sunrise-labs/farmers-iot-toolkit/hardware/hardware.md

# MPPT Solar Charger
Option A)
90W CN3722 Solar MPPT Charger Module 1S 2S 3S 4S Li-ion/LiFePO4 Lead-Acid Battery 7.2V 8.4V 12V 12.6V 16.8V 2A Charging Current
https://www.aliexpress.com/item/1005009883114947.html

Option B)
12V Charging Management 18V Solar 3-series Lithium Battery Charger MPPT Solar Controller CN3722
https://www.aliexpress.com/item/1005004653397155.html

# Solar panel
Voltify Mono PERC Solar Panel 20W 375x350x17mm
https://www.marine-deals.com.au/rv-solar-panels-chargers/voltify-mono-perc-solar-panel-20w-375x350x17mm/p/177917/c/1686
AUD $31.99 (SKU 177917) — also sold on the marine-deals NZ site

Mono-crystalline PERC, 32 cells, 15.44% module efficiency
Max power 20W (+3% tolerance) · Vmp 18.6V · Imp 1.08A · Voc 22.8V · Isc 1.15A
375 x 350 x 17mm, 2.5kg · anodised aluminium frame with mounting slot
3.2mm ultra-white tempered glass · bypass diodes · waterproof (marine-rated) junction box
25-year linear power warranty · IEC 61215 / IEC 61730 / TUV / CE
Vmp 18.6V suits the CN3722 MPPT above (spec'd for an 18V panel into a 3S pack)

# Water level sensor
### went with RS485 variant
Option A)
0-10M Hydrostatic Submersible Level Transmitter 4-20mA RS485 0-5V 0-10V Output for Water Tank Fire Pool IP68 Water Level Sensor
https://www.aliexpress.com/item/1005009844410509.html

Option B)
HTP-300Y Submersible Pressure Transmitter IP68 4-20mA RS485 0-10V 316L Stainless Steel Hydrostatic Level Sensor
https://www.aliexpress.com/item/1005009911856204.html

Option C)
Factory Sale Hydrostatic Submersible Water Level Sensor 4-20ma 0-10V RS485 Output Liquid Level Transmitter QDY30A
https://www.aliexpress.com/item/1005006415176688.html

# Soil sensor
### went with RS485 variant
Measure Soil Moisture Temperature Humidity EC PH NPK 4-20mA 0-5V RS485 Modbus Soil Sensor
Model: THC-S
https://www.aliexpress.com/item/1005001524845572.html

# RS485 components
RS485 RS232 MAX485 TTL CAN to Serial Port Conversion Module Level Convertor Board 232 Turn UART 3.3V 5V MAX485CSA RS-485
https://www.aliexpress.com/item/1005003716689999.html

FT232 USB 2.0 to TTL RS485 485 Serial Converter Adapter FTDI Module FT232RL SN75176 double function double for protection
https://www.aliexpress.com/item/1005006448907596.html

# Diode
1N5819
https://www.aliexpress.com/item/1005001552094086.html

# Mini360 DC-DC Buck
Mini360 DC-DC Buck Converter Step Down Module MP2307 4.75V-23V to 1V-17V 340KHz 17x11x3.8mm For Flight Control Car Module
https://www.aliexpress.com/item/2038556861.html

# Logic Level Control
4 Channels IIC I2C Logic Level Converter Bi-Directional Module 3.3V to 5V Shifter for Arduino
https://www.aliexpress.com/item/1005005984772131.html

# ESP8266
ESP8266 serial port wifi module NodeMCU Lua V3 Internet of Things development board TYPE-C interface CH340
https://www.aliexpress.com/item/1005006889833004.html

# LoRa
### 868mhz variant
Heltec WiFi LoRa 32(V3) Dev-board USB Type C with SX1262 ESP32-S3 LORA node with Wi-Fi BLE LoRa OLED display
https://www.aliexpress.com/item/1005006902338879.html

# MT3608 Boost
MT3608 Boost Module DC-DC Step Up Converter Booster Power Supply Module Board 2A Max 2V-24V To 5/9/12/28V for Arduino
https://www.aliexpress.com/item/1005006361814667.html

# Solenoid Valves
Dc 12V 220V Plastic Electric Solenoid Valve Normally Closed Pressure Solenoid Valve Inlet Valve Inlet Flow Switch
https://www.aliexpress.com/item/1005006146766362.html
