sunrise-labs/farmers-iot-toolkit/docs/bench/max485-hw0519.jpg

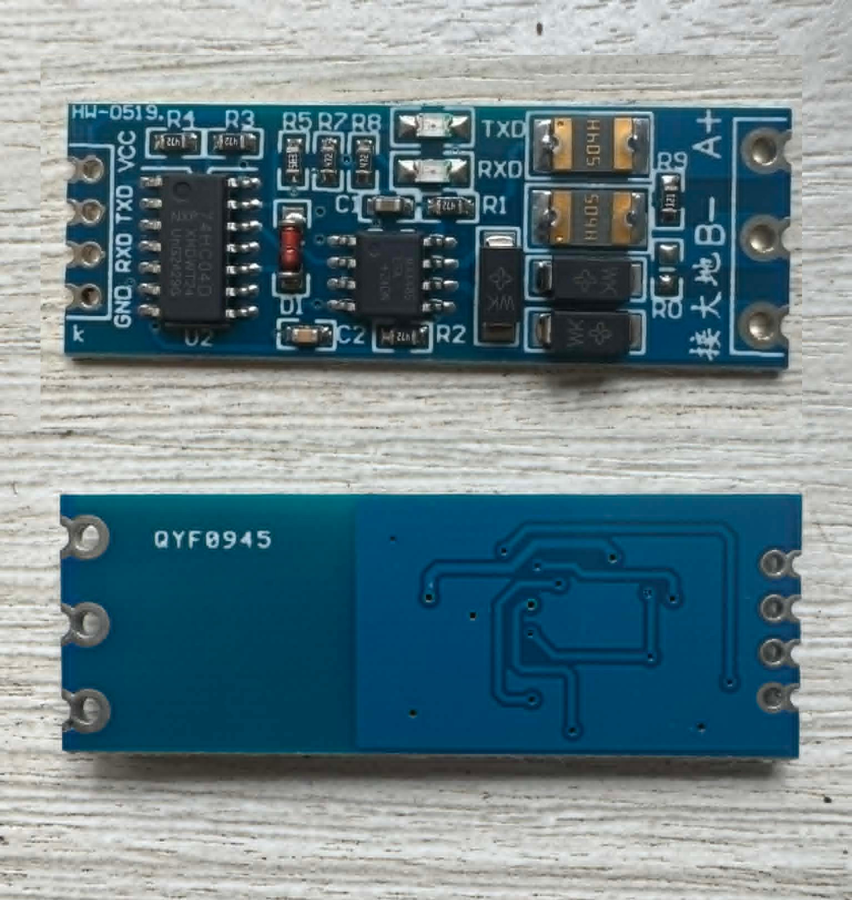
docs/bench/max485-hw0519.jpg
