sunrise-labs/farmers-iot-toolkit/docs/bench/soil-sensor-wires.jpeg

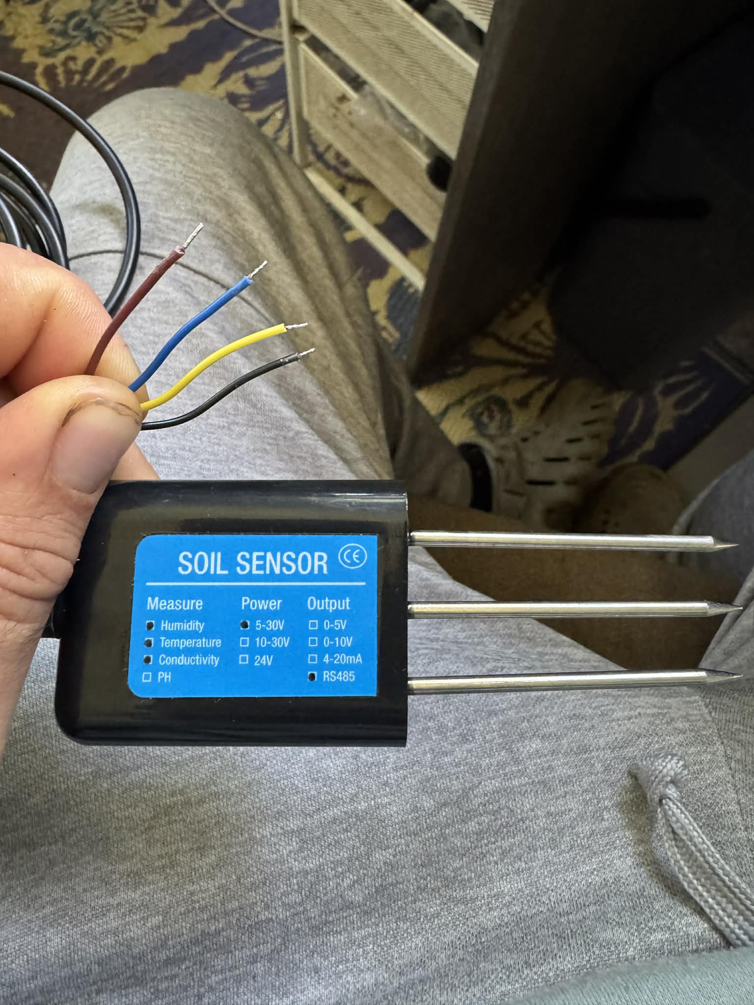
docs/bench/soil-sensor-wires.jpeg
