sunrise-labs/farmers-iot-toolkit/docs/bench/usb-rs485-bottom.jpeg

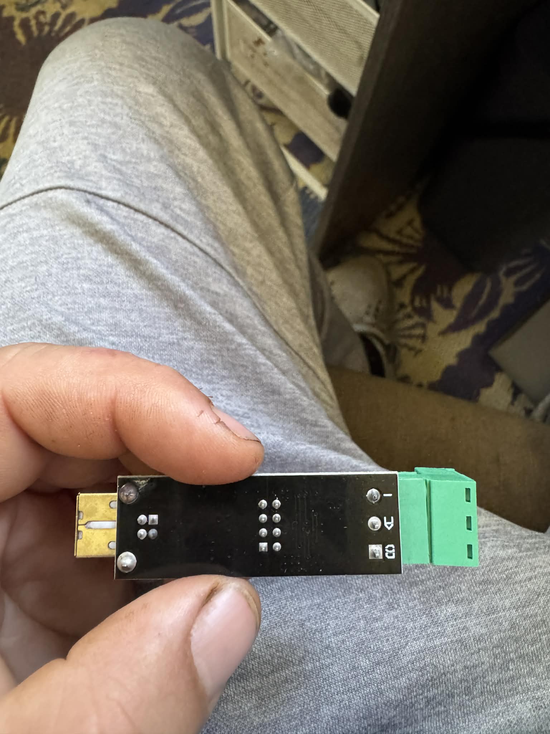
docs/bench/usb-rs485-bottom.jpeg
