sunrise-labs/farmers-iot-toolkit/docs/bench/usb-rs485-top.jpeg

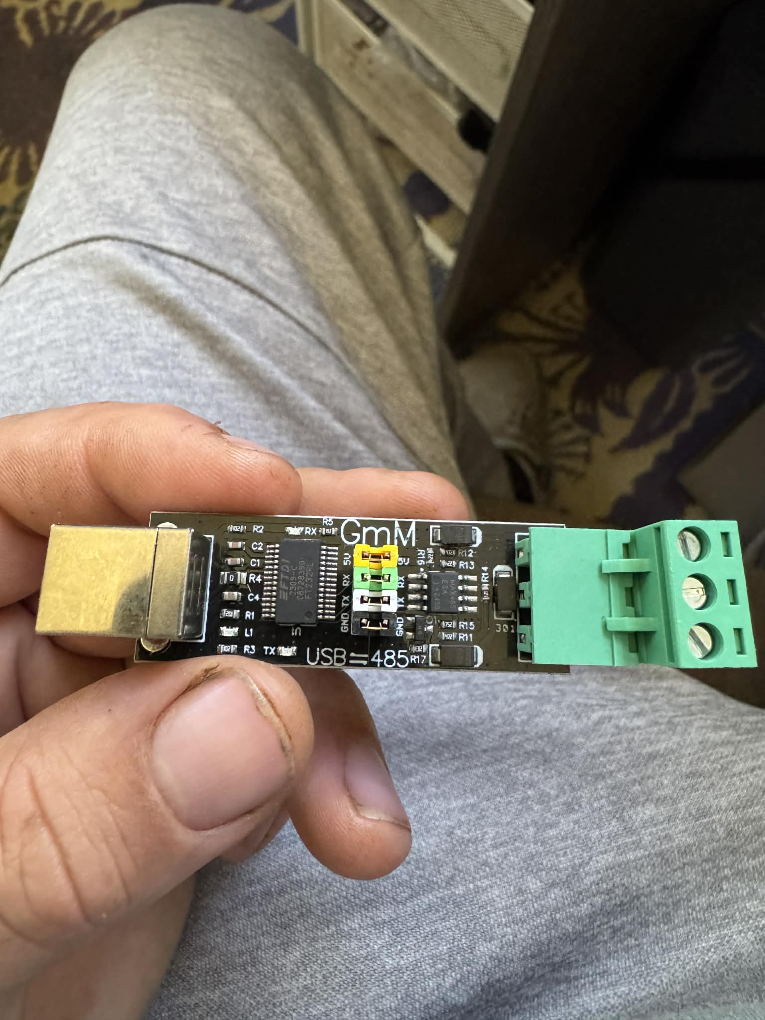
docs/bench/usb-rs485-top.jpeg
