sunrise-labs/farmers-iot-toolkit/hardware/android-charging-2.webp

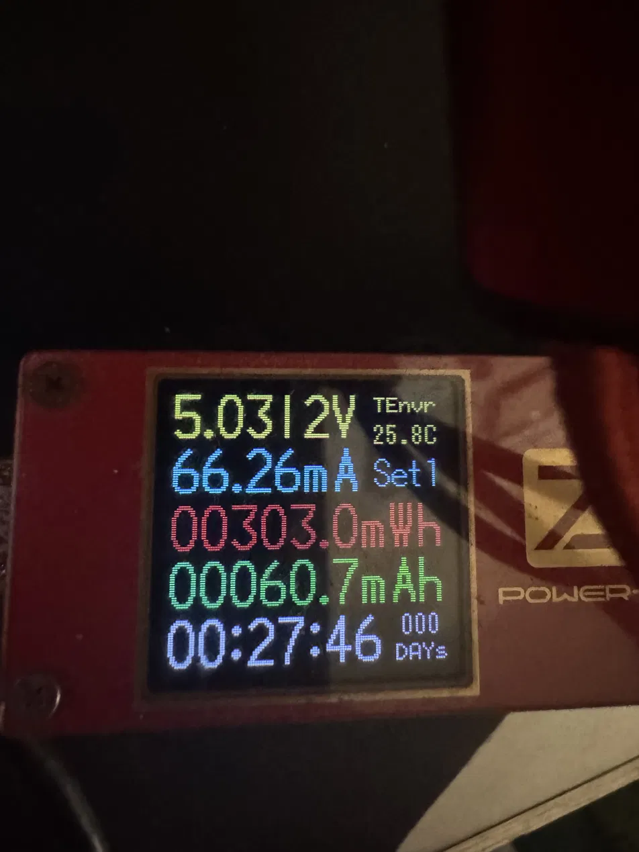
hardware/android-charging-2.webp
