sunrise-labs/farmers-iot-toolkit/hardware/android-charging.webp

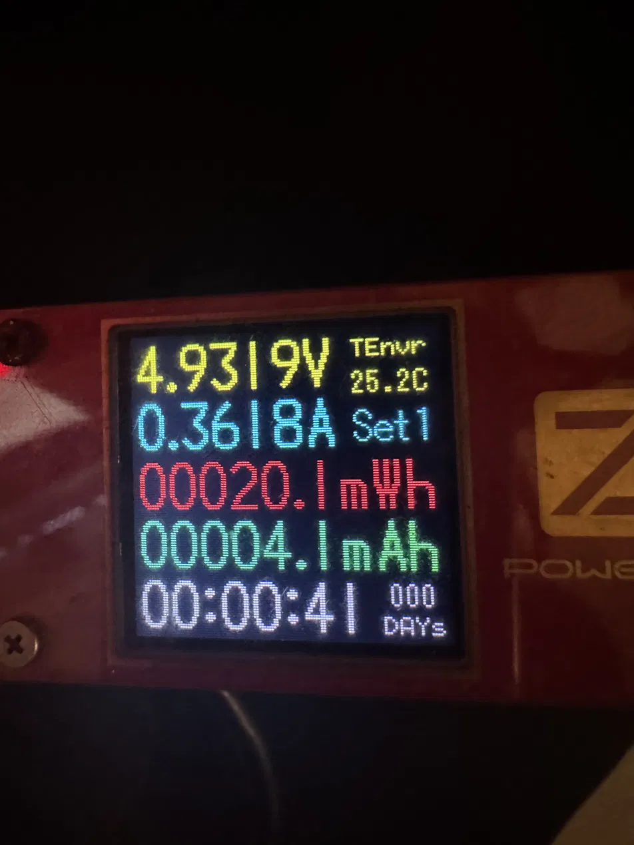
hardware/android-charging.webp
