sunrise-labs/farmers-iot-toolkit/docs/fritzing parts/solenoid-2.jpeg

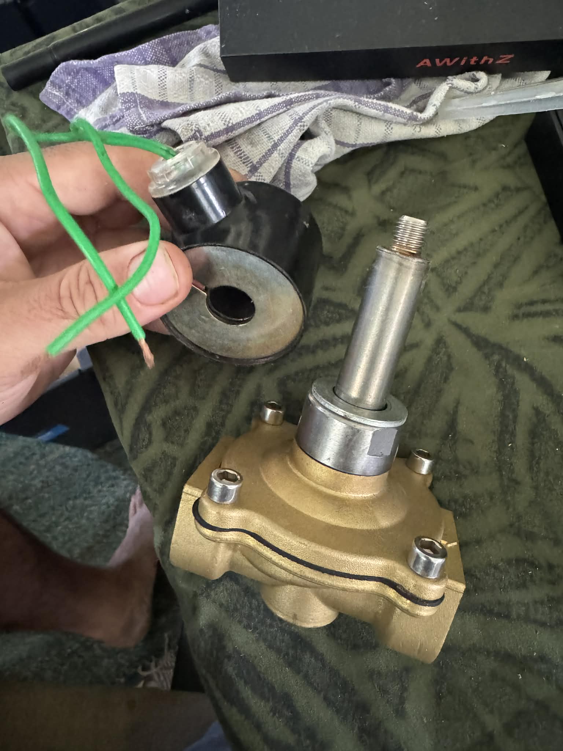
docs/fritzing parts/solenoid-2.jpeg
