sunrise-labs/farmers-iot-toolkit/hardware/Manual - MT3608 Boost.pdf

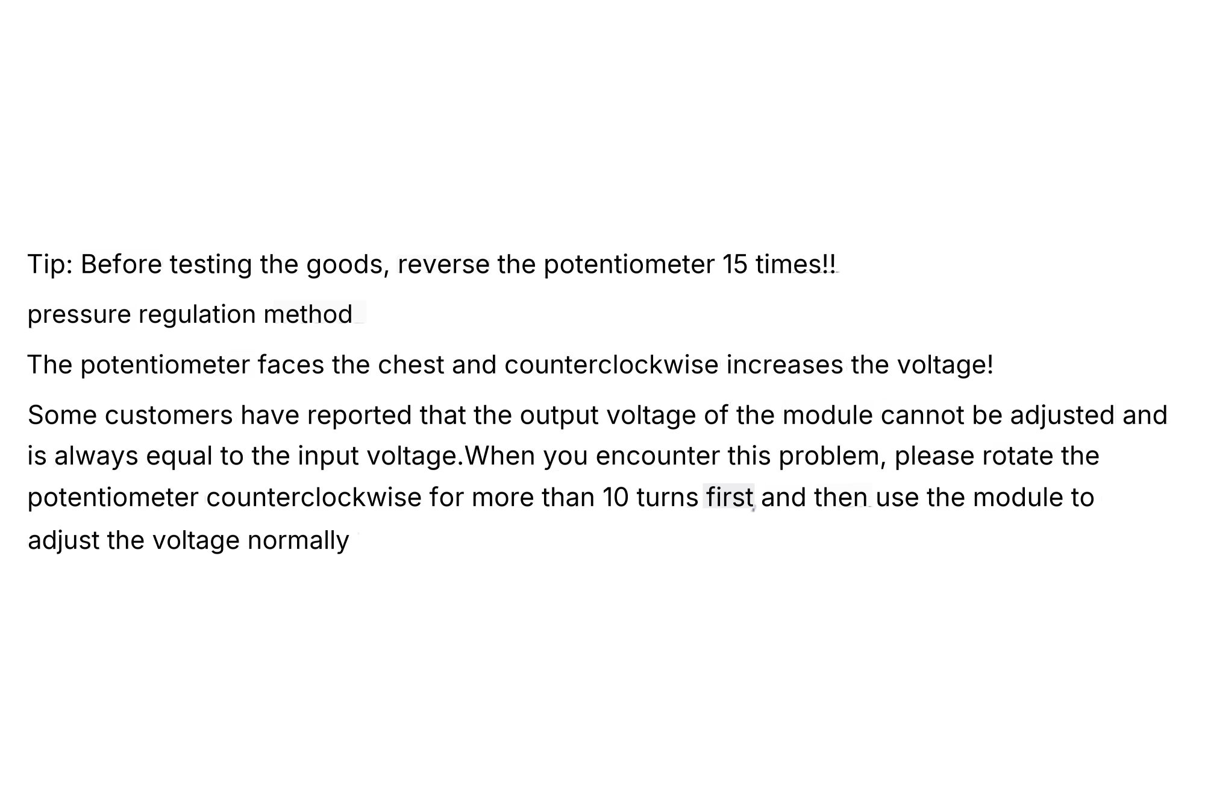
[picture p9: page 1]
