sunrise-labs/farmers-iot-toolkit/docs/wiring-cheatsheet-full.jpg

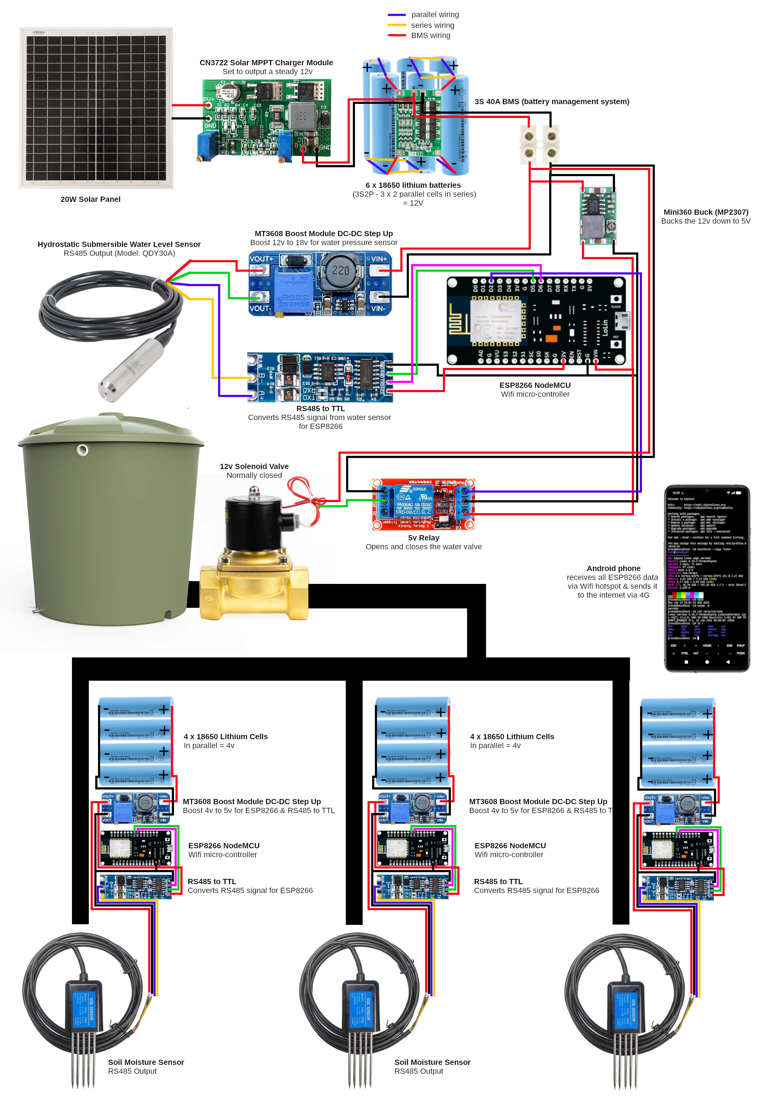
docs/wiring-cheatsheet-full.jpg
