sunrise-labs/farmers-iot-toolkit/docs/wiring-diagram-module-1-power.jpg

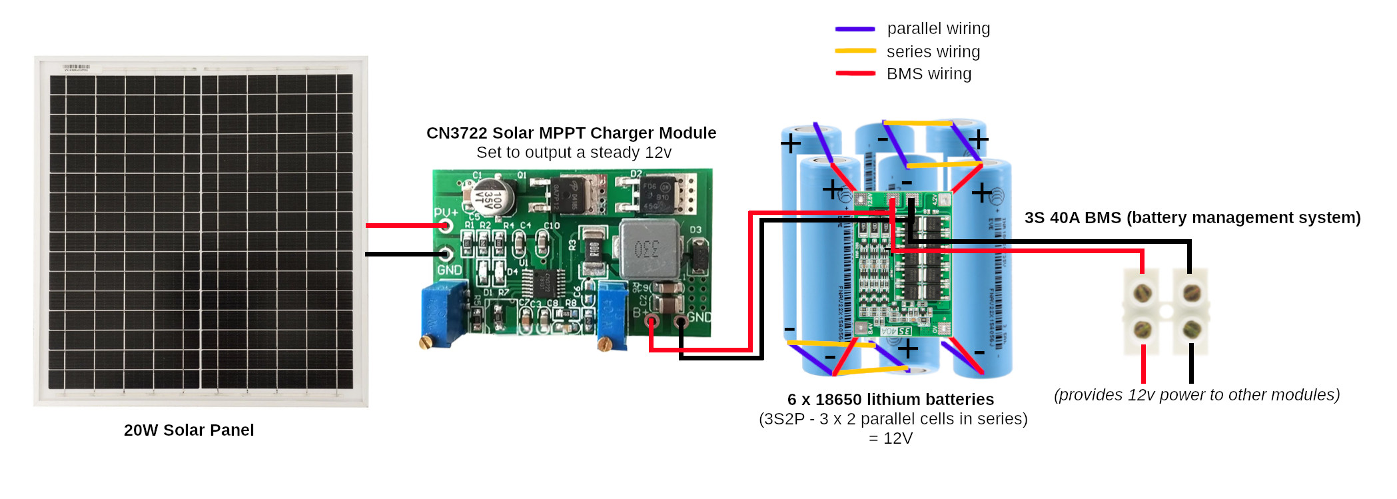
docs/wiring-diagram-module-1-power.jpg
