sunrise-labs/farmers-iot-toolkit/docs/wiring-diagram-module-2-water.jpg

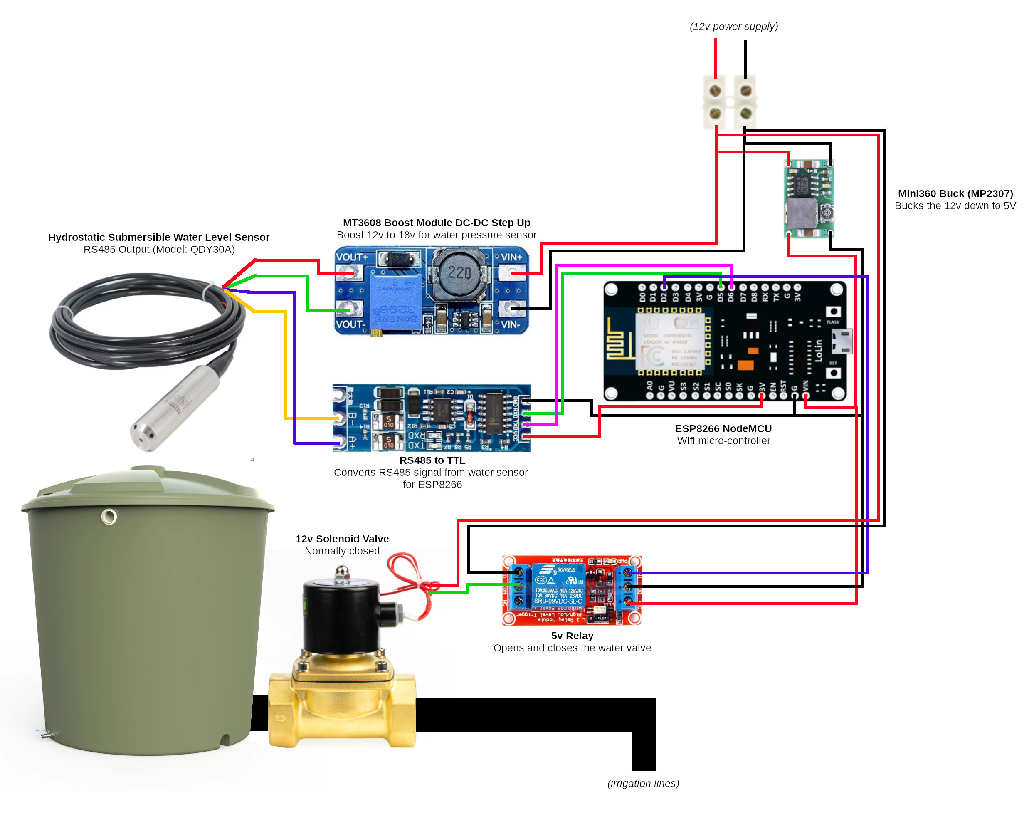
docs/wiring-diagram-module-2-water.jpg
