sunrise-labs/farmers-iot-toolkit/docs/wiring-diagram-module-3-soil.jpg

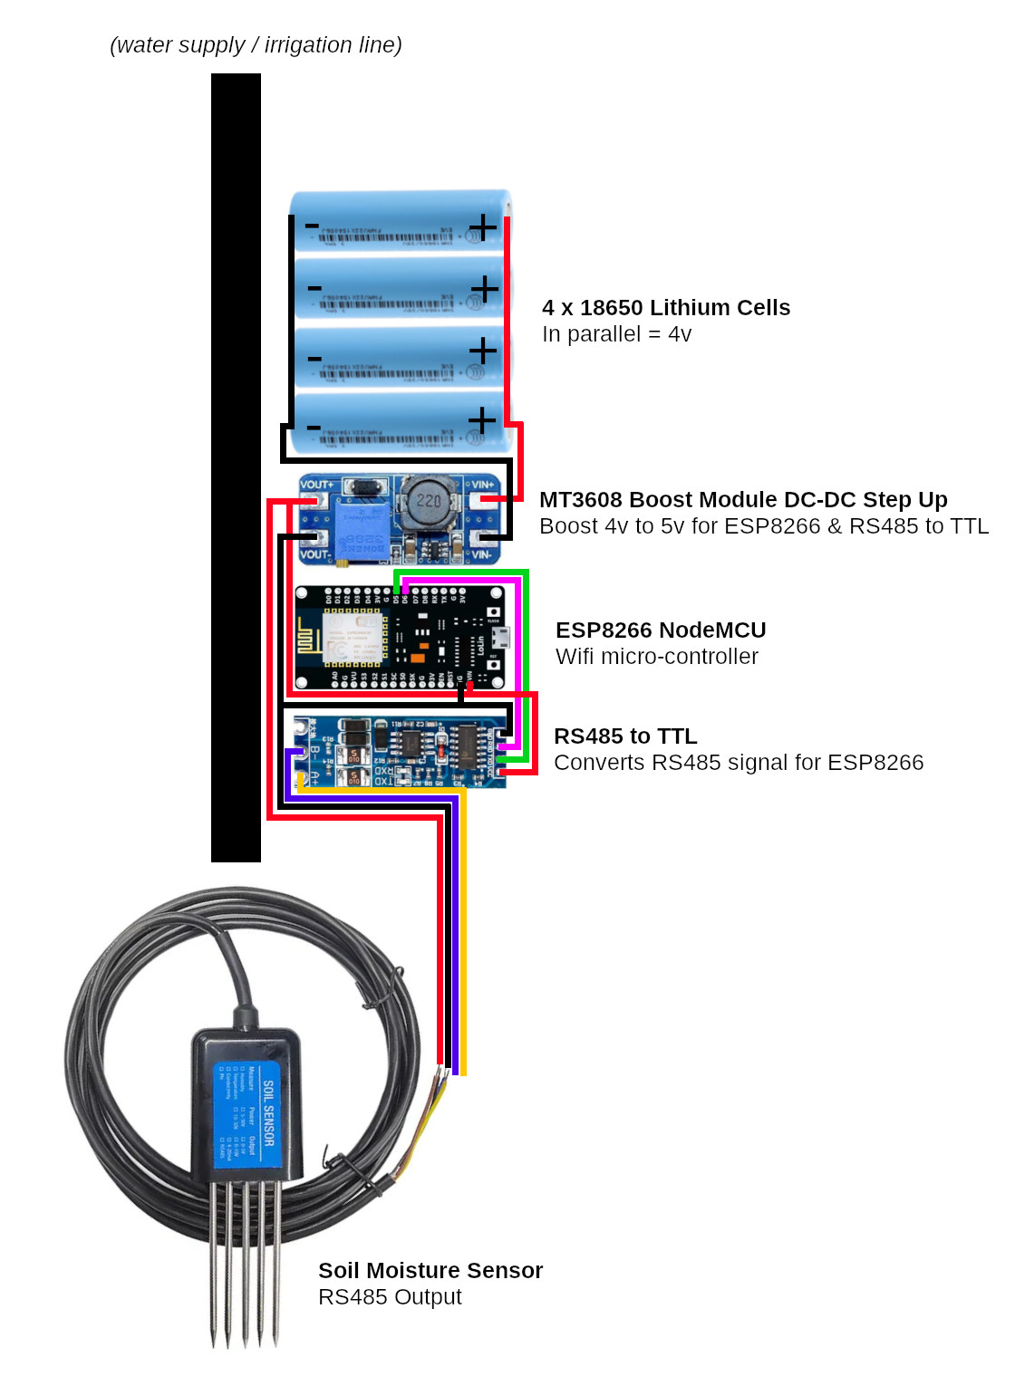
docs/wiring-diagram-module-3-soil.jpg
