sunrise-labs/farmers-iot-toolkit/docs/wiring-diagram-module-4-phone.jpg

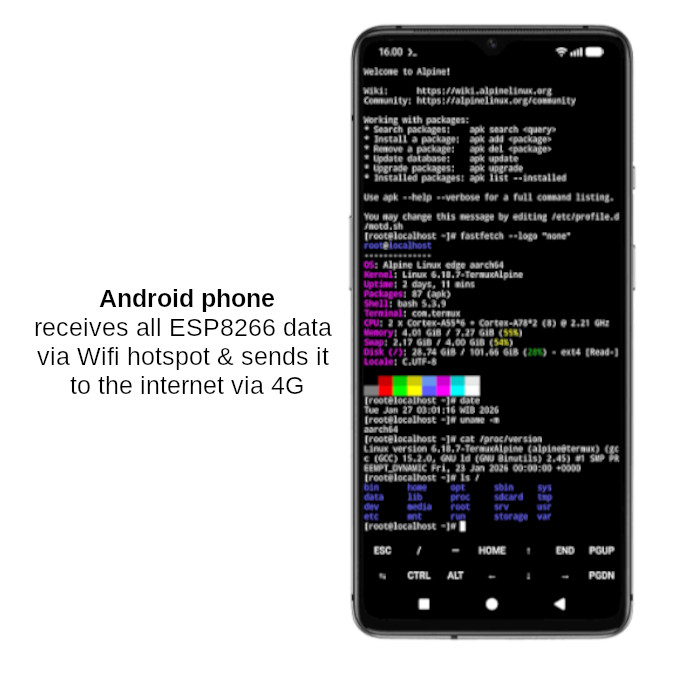
docs/wiring-diagram-module-4-phone.jpg
