sunrise-labs/farmers-iot-toolkit/hardware/Manual - USB to TTL.webp

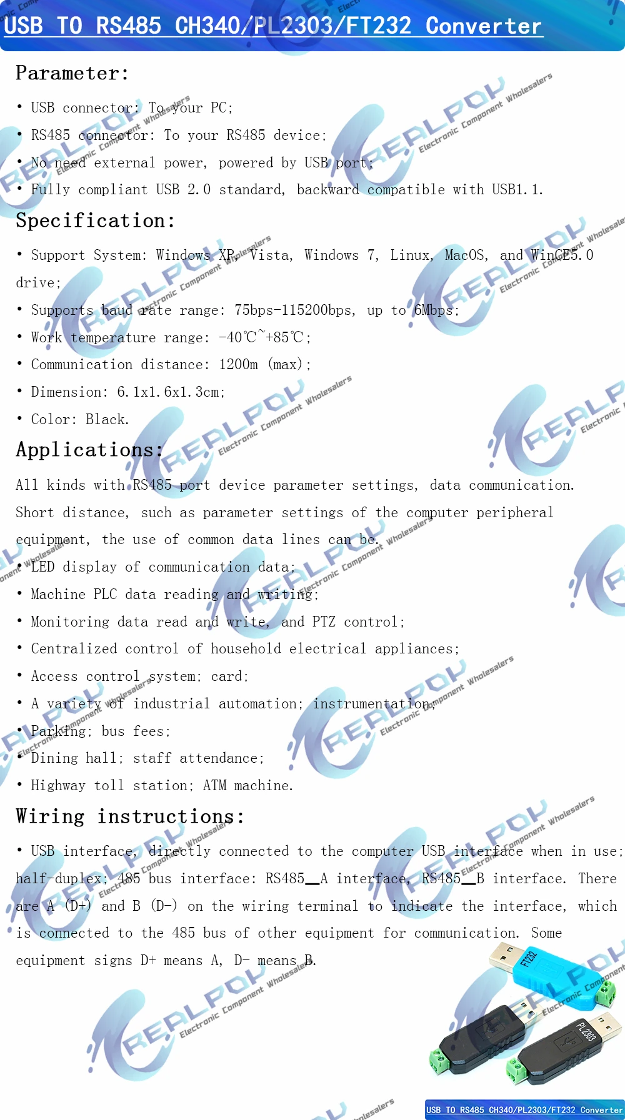
hardware/Manual - USB to TTL.webp
