sunrise-labs/farmers-iot-toolkit/(commit log)

2026-02-24 Initial commit: README, module docs, and Float funding proposal
    Add project README with background on Float discovery proposal,
    4-module overview table, and links to individual module docs.
    Add documentation templates for all 4 modules:
    - Water Tank Level Sensor (beginner)
    - Soil Moisture Sensor to Drip Irrigation (advanced)
    - IoT Solar Powerbank (medium)
    - Mobile WiFi Base Station (beginner)
    Each doc uses YAML front matter for structured metadata and
    plain-language markdown for accessibility.
    Include original Float funding proposal (markdown + PDF).
2026-07-14 Add hardware manuals, soil sensor config tool, and hardware notes
2026-07-14 Add RS485 bench test guides for soil and water level sensors
    Shared bench rig, plus per-sensor walkthroughs for reading Modbus RTU
    into the ESP8266 via MAX485.
    Power: no bench 12V available. Soil THC-S (4.5-30V) runs direct off the
    3S2P pack. Water QDY30A needs 12-36V, so the pack is boosted to 24V with
    the MT3608 rather than run under-spec.
    Water level register map is absent from all three manuals; guide includes
    an empirical discovery procedure instead of a guessed table.
2026-07-14 Add QDY30A Modbus register map from community sources
    Manual has no Modbus section. Map reconstructed from three independent
    HA/ESPHome integrations that agree: addr 1, 9600 8N1, FC 0x03.
    Level in 0x0004 (int16 signed); 0x0002 unit code and 0x0003 decimal
    places set its scaling. Config writes need a follow-up write of 0 to
    0x000F or they are lost on power cycle.
    Verified the community read frame 01 03 00 04 00 01 C5 CB is valid
    Modbus RTU by recomputing its CRC. Semantics still confirmed on-bench
    via block read + ruler calibration.
2026-07-14 Handle unknown water sensor model: 3 options are really 2 sensors
    Options A and C are byte-identical PDFs (same MD5) - both QDY30A. Option B
    is a different sensor entirely (HTP-300Y), whose manual has no wire colours,
    no baud rate and no register map; it defers to 'the wiring definition
    provided by the seller'.
    Drop the boost target from 24V to 18V. Supply ranges are QDY30A 12-36V and
    HTP-300Y 9-24V, overlapping at 12-24V. 18V is safe for either, so the rig
    can be powered before the model is identified. 24V is the HTP-300Y's
    absolute maximum and a bad default while the model is unknown.
    Add an identification section; the step 2 block-read doubles as the
    identification test.
2026-07-14 Record that no HTP-300Y register map exists publicly
    Searched for it; there is no datasheet, community integration, or forum
    thread. Note the false-positive trap: 'HTP Modbus' searches surface Heat
    Transfer Products (a boiler maker) whose Modbus adapter docs look relevant
    but configure via an installer menu on a boiler.
    Advise trying the QDY30A map on it regardless (these transmitters share a
    firmware family), and warn that reads are safe but blind writes can hit the
    address/baud registers and lock you out of the sensor.
2026-07-14 Expand Step 0 into a full walkthrough
    Step 0 was a paragraph pretending to be a procedure. Now covers: what the
    FT232 adapter is and which terminals to use, finding /dev/ttyUSB0 (with
    dmesg fallback), wiring diagram with per-sensor colour table, every mbpoll
    flag explained, the 1-based vs 0-based register off-by-one, what success
    and timeout look like, an ordered fault list, and proving the reading is
    real by making it move.
    Two corrections from checking the actual machine: mbpoll is NOT in the Arch
    official repos (it's AUR - yay -S mbpoll-git), and Ian is already in the
    uucp group so the usermod step was unnecessary.
2026-07-16 feat(bench): prove soil + water RS485 sensors end-to-end
    - add tools/poll-soil.ts (4800) and tools/poll-water.ts (9600),
    adapter-tolerant pollers that work around the FT232+SN75176 CRC/turnaround issue
    - confirm register maps and liveness for both sensors on the bench
    - devlog: bring-ups + gotchas (mbpoll, MT3608 25-turn pot, two-fd at 9600)
2026-07-16 docs(bench): add wiring photos + 3S2P pack handoff doc
2026-07-16 feat(bench): close water sensor ruler test — 1 count = 1 mm confirmed
    Step 4 of the water-level bench guide is done. Four points over a 90 mm span
    fit level_cm = 0.10363 * raw - 1.824 (R2 = 0.9966): within 3.6% of the 0.1
    the register map implies, and 865% from the "raw is cm" alternative.
    The community register map was RIGHT. unit=0x11 (cm) with decimals=1 means
    counts of 0.1 cm, which IS 1 mm/count. The documented mm-vs-cm trap only
    catches people who read decimals=1 and then treat raw as cm anyway.
    Three findings worth more than the verdict itself:
    - You cannot calibrate a 5 m sensor in a bucket. The manual specs 0.5% F.S
    accuracy (±25 mm) and ±2% F.S zero drift (±100 mm), so a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
2026-07-16 docs(module-1): rewrite water tank sensor for the pressure probe we built
    docs/01 described an HC-SR04 ultrasonic sensor on an ESP32 — a design that was
    never built. It's now the QDY30A submersible pressure probe on an ESP8266 +
    MAX485, matching hardware.md, the bench guide, and the rig that just passed its
    ruler test.
    Rewritten rather than patched: the sensor, board, wiring, power chain, scaling,
    accuracy and troubleshooting were all wrong, and a stale beginner guide is worse
    than none — this is the doc a farmer follows.
    Carries over what the bench work actually taught: set the boost to 18V before
    the probe exists, one common ground or you get random failures, 9600 baud here
    vs 4800 f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
2026-07-16 feat(firmware): ESP8266 water level node — reads probe, POSTs JSON to Node-RED
    First of our own firmware. Compiles clean for nodemcuv2 (flash 24%, RAM 36%).
    Not yet flashed or run against real hardware.
    Resolves the "Frugal IoT vs custom" decision that was blocking all sensor
    coding: build it ourselves first, get the system fully working, then evaluate
    what a framework would gain or lose us. You can't judge an abstraction until
    you've felt the problem it claims to solve. Mitra Ardron's collaboration offer
    stands — this is sequencing, not rejection.
    Decides the ESP -> base station protocol, which module 4 never specified:
    HTTP POST of JSON, not MQTT. MQTT means running a broker on an An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
    [config.example.h, water-level.ino]
2026-07-16 feat(firmware): add BENCH_MODE for serial-only bring-up
    First bring-up shouldn't be debugging the RS485 chain and WiFi at once. With
    BENCH_MODE 1 the radio is off, there's no POST, and it polls every 2s straight
    to serial — so a wiring mistake shows up in two seconds instead of being tangled
    up with "is the base station even running".
    Defaults to 1 in config.example.h. A first-time builder gets a working serial
    test immediately, then flips it to 0 once the probe reads reliably.
    Also kills the 20s-per-cycle WiFi wait during bench work, and turns the radio
    off entirely — less power, and less RF noise sitting next to the RS485 pair.
    Both paths compile for nodemcuv2: bench 23% flash, WiFi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
    [config.example.h, water-level.ino]
2026-07-17 fix(firmware): cut modbus read timeout 1000ms -> 300ms
    A dead probe took ~16s to report (15 retries x a 1s deadline), which makes every
    wiring mistake agonising to diagnose and burns solar-node CPU retrying nothing.
    300ms is ~5x the worst real turnaround: a 7-byte reply at 9600 is ~7ms on the
    wire and the probe answers well inside 50ms. The bench poller has been using a
    400ms window reliably since day one. Failure now reports in ~5s.
    Verified on hardware: flashed to the NodeMCU, bench mode boots with no WiFi and
    correctly reports {"ok":false,"error":"no valid modbus frame"} with no probe
    attached — error path confirmed before the sensor is even wired.
    Also worth recording: `arduino-cli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
    [water-level.ino]
2026-07-17 feat(module-1): ESP8266 reads the probe — full chain works on its own hardware
    raw=153 depth=127 mm
    {"node":"water-tank-1","ok":true,"raw":153,"depth_mm":127,"uptime_s":2}
    ESP8266 -> HW-0519 -> RS485 -> QDY30A -> back, CRC-valid, ruler-test scaling and
    dry offset applied. No laptop in the chain. Module 1 stands on its own hardware.
    Two hardware traps found and documented, both of which cost real time:
    1. The MAX485 listing in hardware.md ships TWO different boards. We got an
    HW-0519 auto-direction module with NO DE/RE pins — a 74HC04D derives the
    transmit-enable from TXD itself. Every guide (ours included) assumed the
    classic breakout. Wiring is RXD->D5, TXD->D6, VCC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
2026-07-17 fix(firmware): resync on frame header — kills the auto-direction echo timeouts
    Before: clean reads interleaved with runs of `timeout`, most of the 15-retry
    budget spent to land 5 good samples.
    After: 5 good reads, 0 timeouts, 0 failures in the same 20s window on hardware.
    Cause: the HW-0519 (like the FT232 adapter before it) echoes our own transmitted
    bytes back into the receive path, so the buffer is
    01 03 00 04 00 01 C5 CB | 01 03 02 00 99 ...
    └──── our echoed request ──┘ └── the real reply ──┘
    Parsing from byte 0 landed on the echo, failed CRC, and scored a timeout — the
    same fault that made mbpoll report "Invalid CRC" on every frame back in Jul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
    [water-level.ino]
2026-07-17 docs(module-4): write the Termux + Node-RED steps that were never written
    docs/04 said "(instructions to be added)" for Termux, Node-RED, and the flow —
    module 4 is marked Done in STATUS.md, but the knowledge only existed in Ian's
    head. Six months from now that's indistinguishable from not having built it, and
    it's a deliverable.
    Now documents the three things that actually cost time, none of which are obvious
    and all of which fail in misleading ways:
    - Termux MUST come from F-Droid. The Play Store build is abandoned and frozen;
    pkg installs fail on it looking like network errors, so you blame your wifi.
    - `npm install -g --unsafe-perm node-red` — without the flag it dies partway
    t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
    [water-level.ino]
2026-07-17 feat(firmware): derive the base station address from the gateway, not config
    END TO END WORKING: probe -> ESP8266 -> WiFi -> Node-RED on the phone.
    `POST: 200 ok` with NO IP configured anywhere.
    The Android hotspot is not on 192.168.43.1. Every guide says it is; ours came up
    on 10.215.63.55. Modern Android randomises the hotspot subnet and can reshuffle
    it on any restart or reboot. The first POST failed with -1 against the hardcoded
    address straight out of our own docs.
    The `gateway :` line printed on connect — added about an hour earlier — diagnosed
    that instantly, which is also the clue to the fix: the phone running the hotspot
    IS the node's gateway, by definition. So the node alread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
    [config.example.h, water-level.ino]
2026-07-17 docs(module-2): repin soil RS485 to D7/D1 so both modules share one ESP8266
    The doc still specified D5/D6 — copied from module 1, which collides the
    moment both sensors live on one board. D7/D1 is now the single canonical
    soil wiring rather than an "if you're combining" branch: a standalone
    module 2 loses nothing by using it, and a combined node then just works
    with no rewiring.
    Also caught a conflict this creates: the classic DE/RE breakout wanted D1
    for direction, which is now soil's TXD. That variant takes D2 instead and
    pushes the relay to D5 — and cannot share an ESP8266 with module 1 at all
    (two buses + two DE + a relay needs seven safe pins; there are five). The
    HW-0519's lack of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
2026-07-17 feat(bench): dual-bus bench sketch — proves both sensors on one ESP8266
    Reads water (D5/D6 @9600) and soil (D7/D1 @4800) on two separate RS485
    buses, WiFi off, serial only. Two transceivers rather than one shared bus
    is what lets both sensors keep slave address 1 AND different bauds with no
    register writes — a dollar of hardware instead of a risky write to a
    sensor we own exactly one of.
    Dumps raw bytes on failure. That's what isolated the water fault: soil
    returned a clean n=11 frame while water returned n=0, which exonerated the
    firmware immediately (the known-good water-level.ino failed identically).
    NO DE PIN, deliberately. water-level.ino toggles D1 as DE, which was
    harmless while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
    [bench-both.ino]
2026-07-17 feat(firmware): combined node — both sensors on one ESP8266, POSTs each
    Proven on hardware: WiFi up, gateway auto-derived to the phone with no IP
    configured anywhere, POST /water and POST /soil both 200 ok. Soil reads
    live through to Node-RED.
    Reuses module 1's two hard-won lessons rather than relearning them:
    derive the base station from WiFi.gatewayIP() (Android randomises the
    hotspot subnet, and a hardcoded IP goes stale *silently* — the node keeps
    reading perfectly and publishes into the void), and only publish RSSI when
    there's a link to measure (disconnected it returns a sentinel that looks
    exactly like a real reading).
    Failed reads still POST with ok:false. A node that goes quie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
    [config.example.h, farm-node.ino]
2026-07-17 feat(base-station): Node-RED flow for both sensors, with a live page
    POST /water, POST /soil, and GET / serving a page that shows both. Core
    nodes only — no node-red-dashboard install, keeping the rule that every
    extra install step is a place a build dies on someone else's phone.
    Tracks staleness and marks readings STALE past 90s. Absence is the failure
    you otherwise cannot see: a node that stops reporting produces no error
    anywhere, so the only symptom is a number that quietly stops changing.
    Renders ok:false as a fault card rather than dropping it, honouring the
    firmware's choice to report failures explicitly.
    Supersedes water-level-flow.json — do not import both, two http in nodes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
2026-07-17 docs(devlog): both sensors on one ESP8266 — and the wire that lies
    The session's findings, worst-first:
    THE INTERMITTENT. The water probe went silent, read raw=139 after the heat
    shrink came off, then went silent again — same code, same wiring, three
    results. Firmware, radio, boost and A/B are all eliminated by test, so it's
    a wire; prime suspect green/ground, which is the same wire this devlog
    already fingered for the open FT232 dropout. Probably one fault in two
    costumes. It is provokable RIGHT NOW and stops being findable the moment
    anything gets soldered into a box.
    CORRECTION: neither HW-0519 echoes. The entry below claims it does and the
    resync in water-level.ino is built on that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
2026-07-17 docs: bring STATUS and firmware README up to where the build actually is
    STATUS: module ② sensor half is done, not "to be pre-coded" — THC-S reads on
    the ESP8266 and POSTs to Node-RED. Module ① gains the intermittent as a
    blocker. Critical path reordered: find that wire FIRST, because it's
    provokable now and won't be after soldering.
    Records two decisions made tonight: two RS485 buses rather than one shared
    (a $1 transceiver beats rewriting address+baud registers on sensors we own
    one of each), and that Ian's farm runs ONE combined node while the module
    docs deliberately keep describing two — a farmer must be able to build
    Module ① alone, and the flow supports either.
    Adds the va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
2026-07-19 pcb: scaffold ato project + build-verified architecture skeleton
    Resolve the ATO-HANDOFF start-here steps 1-5:
    - LoRa band -> 915 MHz / AS923 (868 BOM part is wrong variant)
    - KiCad 10.0.3 present; ato build works (plugin-path warning is cosmetic)
    - scaffold farm-node-pcb (main.ato:App)
    - step-4 spine decision: I2C-expander (SC16IS752 + PCF8574) is mandatory
    (Heltec V3 has ~no free GPIO; OLED I2C = GPIO41/42)
    - 5 .ato modules (power/rs485/valve/mcu/main) capture decisions A1-F2 as
    typed-interface stubs; full board ato build -> SUCCESS offline
    Next pass gate: real LCSC part resolution needs network (api.atopile.io
    does not resolve in this env) + a TTY for 'ato create part'.
    [default.kicad_pcb]
2026-07-19 pcb: correct part-backend blocker diagnosis in ATO-HANDOFF
    The picker/registry hosts (components/packages.atopileapi.com) CNAME to a
    globally-NXDOMAIN AWS ELB — atopile hosted infra is down upstream, not a
    local IPv6/VPN issue (earlier note was wrong). Record real bypass options.
2026-07-21 farm-node: active-HIGH valve support, battery-driven solenoid, wiring docs
    - farm-node.ino: VALVE_ACTIVE_LOW handling, fail-safe-closed boot, valve actuation fixes
    - config.example.h: valve polarity + OTA template updates (placeholders only)
    - flows/both-sensors-flow.json: dual-sensor Node-RED flow updates
    - firmware/README.md + devlog.md: 2026-07-17 active-HIGH + solenoid-current findings
    - docs: add wiring-diagram.xcf + fritzing parts; add project CLAUDE.md
    [config.example.h, farm-node.ino]
2026-07-23 bench mobile power
2026-07-23 hardware: Samsung INR18650-32E datasheet — answers the open cell-capacity question
    Ian's pack cells identified: Samsung SDI INR18650-32E (Korea), datasheet v2.0.
    Key specs, and what they change:
    Typical capacity 3200 mAh (min 3100)
    Nominal voltage 3.65 V <- not the 3.7 V assumed everywhere
    Charge / cutoff 4.2 V / 2.50 V
    Max continuous 6400 mA discharge, 3200 mA charge
    Operating temp CHARGE 0-45 C, discharge -20 to 60 C
    Internal impedance <= 35 mOhm
    3S2P pack maths, now measured rather than inferred:
    3 x 3.65 V = 10.95 V nominal (docs say 11.1)
    2 x 3200 mAh = 6.4 Ah
    6.4 Ah x 10.95 V = ~70 Wh typical (~68 Wh at minimum capacity)
    That is 27% more than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
2026-07-23 docs: propagate the real cell specs — pack is 70Wh, and charging stops at 45C
    Follows 5b81cc3 (the INR18650-32E datasheet). Every pack figure in the repo was
    back-derived from docs/03's own "44 Wh at 80% DoD" line, which implied ~2500 mAh
    cells. The datasheet says otherwise.
    was assumed actually
    Cell ~2500 mAh, 3.7V 3200 mAh (3100 min), 3.65V
    Pack 11.1V, ~55 Wh 10.95V, 6.4Ah, ~70 Wh
    @80% DoD 44 Wh 56 Wh
    Everyday 28-33 Wh ~38 Wh
    27% more pack. Autonomy figures improve accordingly (phone-attached wet-season
    drain 2-4 -> 2-5 days; phone autonomy 0.5-1.3 -> 0.6-1.5 days). No design
    conclusion changes: the bi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
2026-07-23 chore: track the /prime slash command, refreshed to current state
    It was sitting untracked on one machine. It is project context — anyone
    cloning should get the same priming, and it shouldn't drift silently.
    Refreshed section 4, which had gone stale:
    - Module 3: cells identified (Samsung INR18650-32E) -> pack is ~70Wh /
    ~38Wh everyday-usable, charging rated 0-45C only.
    - Module 2: valve-power question narrowed -- ~53 mOhm pack impedance means
    the sag to 9.0V is state-of-charge, not the solenoid. Don't hunt for
    dynamic sag.
    - Module 4 added: phone power designed but unmeasured, blocked on a 24h
    measurement, bench sheet ready at docs/bench/03-bench-phone-power.md.
    - Open decisions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
2026-07-23 devlog: first USB-meter reading on the OPPO — 4.93V/0.36A/1.78W snapshot
    Photo hardware/android-charging.webp + a devlog entry.
    Readings cross-check (20.1 mWh / 4.1 mAh = 4.90V avg; 4.1 mAh / 41s = 360 mA),
    so the frame is trustworthy. Two takeaways:
    - Charge path works — phone accepts power through the meter.
    - Voltage already low: 4.93V at only 0.36A. A healthy 5V source holds
    ~5.0-5.1V this lightly loaded, so ~0.07V is already lost before real
    current flows — at ~2A this source+cable would sag under the 4.75V floor
    and the phone would trickle. The "short thick cable / set buck 5.15-5.2V"
    gotcha, live on the first reading.
    Explicitly NOT the budget number (Test 3 wants ste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
2026-07-23 devlog: second USB-meter frame — charge curve tapers, ~0.34 ohm cable drop
    Both readings are from a PC USB port, NOT the pack (corrects frame-1 entry
    which speculated about the source).
    frame 1 4.9319V 361.8mA 1.78W 00:00:41
    frame 2 5.0312V 66.3mA 0.33W 00:27:46 (60.7mAh/303mWh cumulative)
    Current tapered 362 -> 66 mA: a charge curve flattening, frame 2 is
    near-full trickle. The two load points give effective series resistance
    ~0.34 ohm (PC-port cable + connectors + meter), implied Voc ~5.05V ->
    at 2A terminal would be ~4.4V, under the 4.75V floor. Quantifies the
    frame-1 "4.93V looks low" hunch, but it's a PC cable, not the deployed
    buck path, so it demonstrates the mechan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
2026-07-26 docs: full deployment wiring diagram — the one box we actually run
    Every net in the deployed rig in one file: power tree from panel to each
    load, the as-soldered ESP8266 pin map, both RS485 buses with their
    (different!) colour conventions, the valve chain, ground topology, and
    the HTTP endpoints.
    Flags one undocumented drift: farm-node.ino runs water on D7/D1 and soil
    on D6/D5, swapped versus CLAUDE.md, STATUS.md, config.example.h and
    docs/02. The iron is right and the prose is stale — anyone rebuilding
    from the docs wires two dead buses.
2026-07-27 feat: deep-sleep soil-only node — battery-swap variant, spec + guide + firmware
    New firmware/soil-node-sleep/ (self-contained per module-sketch convention,
    Modbus code copied from proven farm-node): wake -> read THC-S -> POST /soil ->
    deep sleep N min. D0->RST wake jumper, bounded WiFi wait so a dead hotspot
    can't flatten the cells, optional A0 battery gauge with low-battery park,
    optional D2 low-side FET sensor gating. Compile-verified both modes; not yet
    flashed on hardware.
    docs/deep-sleep-soil-node.md: spec, battery math (1S3P ~3wk simple / ~2mo
    gated; 1S4P ~4wk / ~3mo), wiring, 9-step build guide, gotchas.
    [config.example.h, soil-node-sleep.ino]
2026-07-29 deep-sleep node bench-proven — and the zombie-wake culprit was the flash chip
    Two NodeMCUs failed every self-wake identically: wake reset fires on time,
    boot ROM starts (rst cause:2, boot mode 3,6 — decoded at 74880), then hangs
    before the first flash read. Eliminated jumper/diode, sleep-entry pattern,
    and MT3608 transients (USB-only failed the same). flash_id named it:
    both failing boards carry anonymous 0xC4 clone flash that can't wake from
    deep-power-down in time; a Winbond (0xEF) board self-woke 4/4 with a plain
    wire — no diode, no cap.
    - devlog: full elimination path + the flash_id acceptance rule
    - guide: new step 0 (check flash chip BEFORE building), hotspot/phone
    gotchas, Wi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
    [soil-node-sleep.ino]
2026-07-29 guide: XMC (0x20) flash bench-proven for deep sleep — second node (soil-bed-2) built
    5/5 self-wakes on an XMC-flash board at 1-min cadence. Approved flash list
    now: ef (Winbond), c8 (GigaDevice, by reputation), 20 (XMC). c4 stays banned.
    Unlisted vendors: run the 1-min wake test before trusting.
2026-07-30 hardware: add the 20W Voltify Mono PERC panel with full electrical specs
2026-08-01 server: push farm telemetry out to a VPS instead of exposing the phone
    The base-station phone is behind carrier CGNAT — there is no inbound port and
    no address to forward. Rather than tunnel in, the phone now dials out: Node-RED
    buffers every reading and POSTs it in batches to farm-ingest on the VPS.
    - server/ingest.ts — bun + bun:sqlite receiver, no dependencies. Bearer auth,
    a read-only page, JSON API, 400-day retention.
    - flows/push-to-cloud-flow.json — eight core nodes, no installs. URL and token
    live in one function node.
    Four things that are load-bearing:
    - client_id makes redelivery idempotent. Store-and-forward re-sends any batch
    whose response was lost; without a dedu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
2026-08-01 server: per-node dashboard cards and a valve downlink
    Two asks: show every soil bed, and control the valve from the dashboard.
    Cards are now keyed on node rather than sensor kind, so soil-bed-2 and -3
    appear the first time they report — flashing a node is the whole install, no
    code edit. Staleness is learned per node (3x its own median gap, floored at
    5 min) because the deep-sleep battery-swap node's cadence is nothing like
    farm-node's, and one fixed threshold would either cry wolf over the sleeper
    or stay green for hours after a live node died.
    The valve is the harder half: the phone cannot be dialled into, so a command
    has to be something it collects. It already POSTs batches, so every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
2026-08-01 flows: local /page dashboard shows every node, mirroring the cloud view
    The local page kept one slot per sensor KIND, so soil-bed-2 overwrote
    soil-bed-1 and the page showed whichever reported last with no hint the
    others existed. The store functions now keep a map keyed on node, and the
    page renders one card each — a new bed appears by reporting, not by an edit.
    Deliberately mirrors farm.sunriselabs.io: same card layout, same colour
    semantics, same valve panel wording. Same system, two windows — and this one
    keeps working with no internet, which is the whole reason it exists.
    Also here:
    - Staleness is learned per node from a short rolling history of arrival gaps
    (3x median, floored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
2026-08-01 dashboards: say CLOSED rather than SHUT for the valve
    Ian's wording. Applied to both views so they stay identical: the state
    readout, the button label, the confirmed-vs-commanded line, and the valve
    chip on soil cards. The cloud button id follows (vshut -> vclose) so the
    markup does not disagree with the label.
2026-08-02 fix: the firmware reports valve as "open"/"closed", not 1/0
    farm-node.ino line 417 emits the pin state as a STRING. Both dashboards
    assumed a number, and got it wrong in two different ways:
    - The server stored anything non-numeric as NULL, so every field reading's
    valve state was silently dropped.
    - The local page truthiness-tested the raw value. A non-empty string is
    truthy, so "closed" rendered as **valve OPEN** — the page confidently
    reported the opposite of the truth, and the valve panel's confirmation
    line agreed with it. Worse than showing nothing.
    Normalised in one place on each side, accepting open/closed/shut/true/false/
    1/0 in either type. Backfilled 183 historical rows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
2026-08-04 farm-node: ENABLE_SOIL flag — stop publishing a probe that isn't there
    The soil probe moved to its own deep-sleep node, but the combined sketch kept
    polling an empty bus and POSTing {"node":"soil-bed-1","ok":false} every cycle.
    The waste was not the point. It published under the SAME node name as the real
    soil-bed-1, so two devices wrote into one identity and the dashboards
    interleaved a healthy deep-sleep node with a phantom failing one. That is where
    the "90% soil-bed-1 fault rate" on 2026-08-01 came from — a probe that was not
    connected to the board reporting it.
    ENABLE_SOIL is compile-time and defaults to 1, with an #ifndef fallback so an
    un-updated config.h behaves exactly as befo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
    [config.example.h, farm-node.ino]
2026-08-05 farm-node: delete the soil half outright, not just flag it off
    ENABLE_SOIL 0 stopped the phantom soil-bed-1 POSTs but left the bus
    compiled in behind a flag defaulting to 1 — one stale config.h away
    from two devices publishing under one node name again, which reads on
    the dashboard as a healthy node being 90% faulty.
    Removed SOIL_* defines, the second SoftwareSerial, readAndSendSoil(),
    NODE_ID_SOIL, POST_PATH_SOIL and every #if ENABLE_SOIL. The valve's
    pin state already rides on /water, so nothing loses visibility.
    Safe because no module doc pointed a farmer at farm-node/ (docs/02
    points at the unwritten firmware/soil-moisture/), and the
    one-ESP-two-buses demonstration still lives in fir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
2026-08-05 farm-node: turn the valve's dead-man timer on (1800s), and default it on
    VALVE_MAX_OPEN_S has been 0 since the valve shipped. Remote control
    going live on 2026-08-01 made that materially worse: the server's
    FARM_VALVE_TTL_S expiry cannot help when the LINK is what failed. A
    failed valve poll deliberately holds the last state, so an open valve
    plus a dead hotspot stays open until someone walks out to it.
    The node-side timer is the only guard that runs while the node is
    alone. 1800s mirrors the server default so both ends agree on one
    ceiling.
    config.example.h now defaults to 1800 rather than 0 — a teaching
    toolkit whose flood-safety timer ships disabled, with a comment
    suggesting you enab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
    [config.example.h]
2026-08-06 site: the Toolkit website — hero, modules, cheatsheet, four deep dives
    Critical-path item 5 in STATUS.md. Six static pages built by `bun site/build.ts`
    into site/dist/: a hero in float.ag's register, the four modules and how they
    interact, a video summary slot, the full wiring cheatsheet, and a deep-dive page
    per module with wiring, a BOM with buy links, and a step-by-step walkthrough.
    No framework, no bundler, no dependencies, and no third-party request of any
    kind — the fonts are self-hosted (230 KB) so a farmer on metered 4G talks to
    exactly one host. Output is relative-linked static HTML with a .nojekyll, so it
    drops onto Float's site, GitHub Pages or the hetzner box unchanged; the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
2026-08-06 docs: update the wiring diagram GIMP source
2026-08-07 site: publish dist/ to GitHub Pages from CI
    Builds with bun rather than uploading the committed dist/, so a forgotten
    rebuild cannot serve a stale page. Warns in the job summary when the copy
    in git has drifted. Pages must be switched to the GitHub Actions source
    before the first deploy succeeds — hosting is still an open decision.
2026-08-07 site: renumber the modules to match the build, and use the real wiring photos
    The four modules are now 1 Power, 2 Water + valve, 3 Soil, 4 Phone. That is
    build order and it is how the farm is actually wired: the valve lives on the
    water node because that is where the tank is, and the soil probe is its own
    deep-sleep node on its own 1S4P pack. The docs/0N-*.md filenames keep their old
    numbering; docPath maps between them so nothing under docs/ had to move.
    The generated SVG wiring diagrams are gone, replaced by photographs of the real
    build. A farmer matching a picture to the parts in their hand is doing something
    a schematic cannot help with. The pin and register tables are still rendered
    f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
2026-08-07 farm-node: dump n and the raw RS485 bytes on a failed read (bench only)
    A failed exchange only printed "no valid modbus frame", which hides the one
    distinction that matters when the probe goes quiet: n=0 means nothing reached
    the ESP at all (probe silent, or RXD never reaches D7), while n>0 means the
    probe IS replying and something is mangling it. Different faults, different
    hunts. Compiled out unless BENCH_MODE, so the field build is unchanged.
    [farm-node.ino]
2026-08-08 water probe: the intermittent was a dying transceiver, not a wire
    Swapped the HW-0519 for the spare and the probe answers. Six weeks of
    "it's a wire" was wrong, and the reason it took six weeks is worth
    keeping: the fault map's "TXD blinks, RXD doesn't -> A/B swapped" is
    right for a NEW build and misleading for one that worked yesterday.
    Polarity, baud and pins are static. What "it worked before" points at
    is a component that degrades, and that was never on the list.
    Eliminated by measurement, not argument: 18 V held at the probe DURING
    the failure (which also killed the "one intermittent, two costumes"
    theory - the FT232 dropout is now open and separate again), A/B read
    9.16k so both condu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
